connorwhite-online/hum/docs/props-v3.png

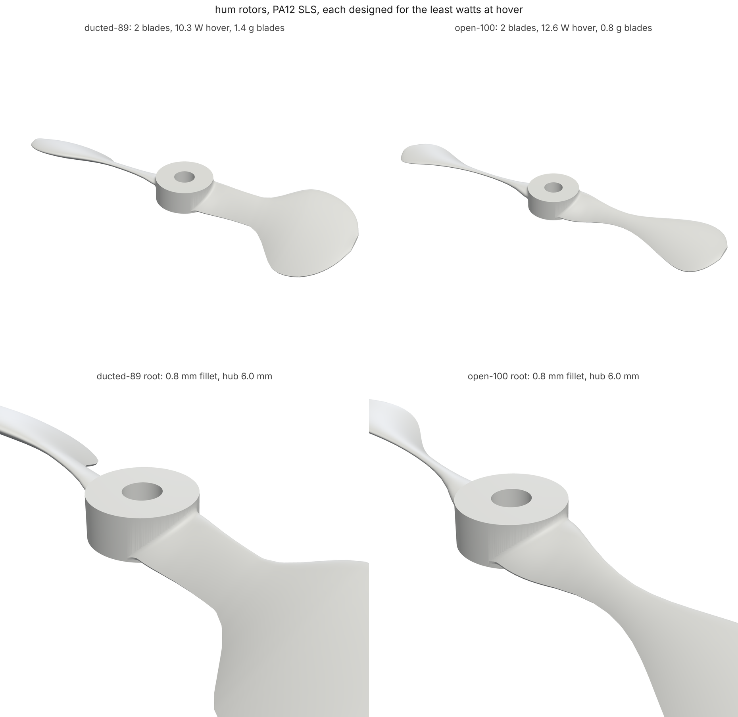
docs/props-v3.png
