connorwhite-online/hum/out/props/ducted-89-ccw.stl

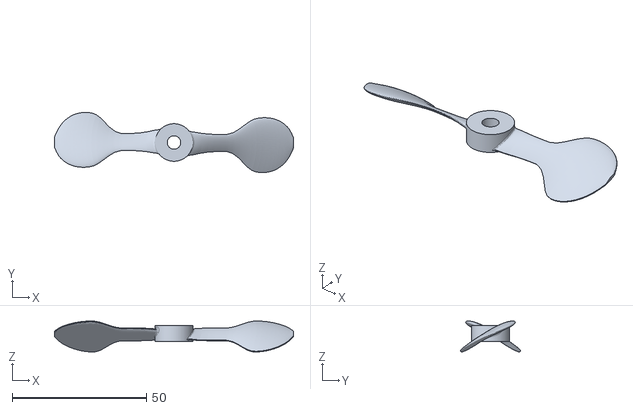
[picture p2: CAD file, 2026-11-11]
out/props/ducted-89-ccw.stl
88.9 x 22.4 x 11.5
