connorwhite-online/hum/out/props/open-100-ccw.stl

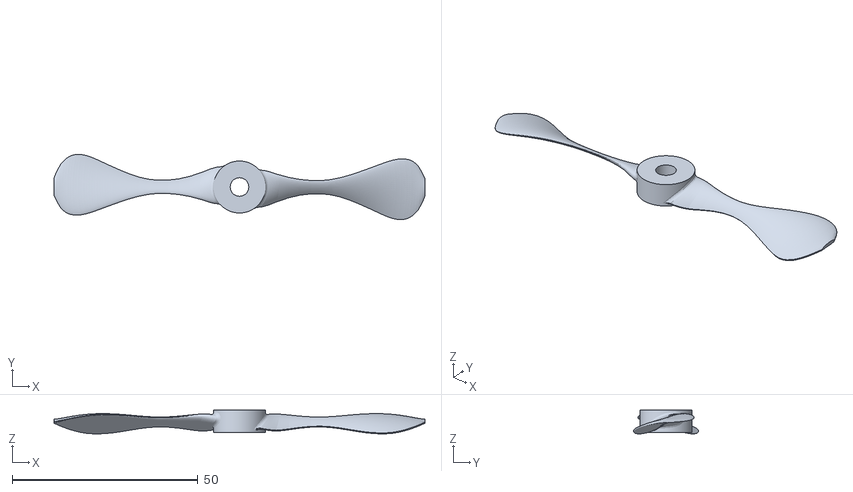
[picture p3: CAD file, 2026-11-11]
out/props/open-100-ccw.stl
100.0 x 17.6 x 6.39
