connorwhite-online/hum/(list of files, cad)

Other CAD files:
out/props/open-100-cw.stl
out/props/ducted-89-cw.stl
