connorwhite-online/hum/(commit log)

2026-11-10 hum: a 3.5 in ducted quad designed with loadpath; spec, physics, frame study, gap log
    Claude-Session: https://claude.ai/code/session_01HFwANWSoALG9Kqqzimpv6W
2026-11-10 Bumpers: graded FDM TPU tyres from the crash energy; frame loads from what they let through
    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
    [bumper.py, frame.py]
2026-11-10 Frame: crash cases carry their own safety factor (1.25) instead of scaled forces
    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
    [frame.py]
2026-11-10 Gaps: free-part islands and staircase duct walls fixed in loadpath
    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
2026-11-10 Firmware (Betaflight diff from the drone's physics), BOM and wiring
    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
    [betaflight.txt]
2026-11-10 Frame: prop-wake blockage as a cost and hot motor bases in the study
    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
2026-11-10 Frame: a 3 mm seat band behind the bumper for a ring beam; bumper crash forces from the point-contact model (wall 596 N)
    The first verified frame read SF 0.1 in the crashes: the tyre pressed on a bare
    1.2 mm duct wall with no room behind it for structure.
    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
    [bumper.py, frame.py]
2026-11-10 Frame: only a 0.8 mm duct skin is drawn; the design thickens the duct where loads need it
    Even a 209 g frame read SF 0.42 in the corner drop, peaking in the drawn 1.2 mm
    duct wall the optimizer could not change.
    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
2026-11-10 Frame crash cases as impacts: bumper and frame in series (loadpath 3e6f4f5)
    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
    [bumper.py, frame.py]
2026-11-10 Frame: a drop whose line of hit runs through the centre of mass (all 316 g, full 6.2 J on one tyre)
    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
2026-11-10 Crash rating 1 m drop / 3 m/s wall (2 m / 4 m/s unreachable at a flying weight); bumper regraded
    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
    [spec.py]
2026-11-10 Rough assembly render (designed frame + stand-ins)
    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
2026-11-11 Rotors designed with loadpath.propeller: open 89, ducted 89, open 100 mm on the 1804 and 4S pack
    Full-throttle thrust from the mission (hold height at 60 deg bank carrying 100 g:
    2.04 N per rotor). Hover watts from the pack, on the flexing PA12 blade:
    ducted-89 2-blade 9.7 W (incl. 1.2 W duct losses), open-100 3-blade 10.2 W,
    open-89 4-blade 11.4 W. GAPS 17-19.
    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
    [ducted-89-ccw.stl, ducted-89-cw.stl, open-100-ccw.stl, open-100-cw.stl, open-89-ccw.stl, open-89-cw.stl]
2026-11-11 Props: roots necked to the motor's 6 mm hub, fillets from root stress, solid check; v3 renders
    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
    [ducted-89-ccw.stl, ducted-89-cw.stl, open-100-ccw.stl, open-100-cw.stl, open-89-ccw.stl, open-89-cw.stl]
2026-11-11 Gaps: prop root/hub fit (20), beam vs solid root stress (21); drop the open-89 rotors (no feasible design on the 6 mm hub)
    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
    [open-89-ccw.stl, open-89-cw.stl]
2026-11-12 Gaps 22: stiff PA12 ducted frame fails the crash rating at 148 g
    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
2026-11-12 Gaps 22: the TPU tyres are already there; PA12 specific strength is the limit
    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
2026-11-12 Carbon-core frame study (four 8 mm pultruded tubes, bonded) and the failing run's input and log
    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
    [frame.py]
2026-11-12 Carbon frame: envelope 2 mm lower so the tubes sit wholly under the motor base
    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
2026-11-13 Gaps 23: carbon core holds, the printed duct ring is what breaks
    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
2026-11-13 Carbon frame report for the stock thread
    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
2026-11-13 Gaps 23: the carbon frame's bond readings were a library artifact (fixed in loadpath d7a46ce)
    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
